Abbas1243/Decentralised_swarm_autonomous_ground_vehicle/software/simulation/frames_2026-03-26_16.52.51.pdf

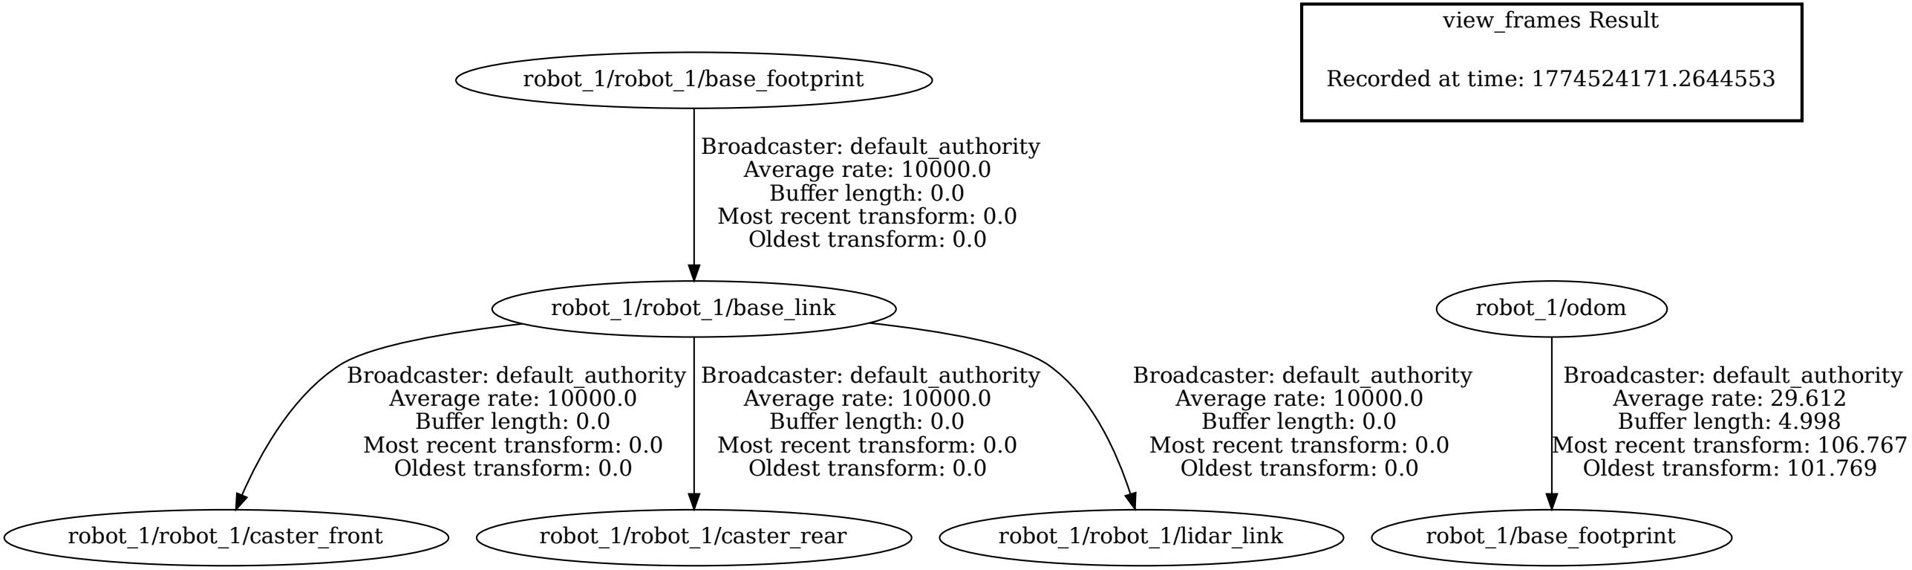
[picture p4: figure]
view_frames Result; robot_1/robot_1/base_footprint; robot_1/robot_1/base_link; Broadcaster: default_authority Average rate: 10000.0 Buffer length: 0.0 Most recent transform: 0.0 Oldest transform: 0.0; robot_1/robot_1/caster_front; robot_1/robot_1/caster_rear; robot_1/robot_1/lidar_link; robot_1/odom; robot_1/base_footprint; Broadcaster: default_authority Average rate: 29.612 Buffer length: 4.998 Most recent transform: 106.767 Oldest transform: 101.769; Recorded at time: 1774524171.2644553
