Abbas1243/Decentralised_swarm_autonomous_ground_vehicle/software/simulation/frames_2026-03-26_17.04.20.pdf

view_frames Result

Recorded at time: 1774524860.1898923

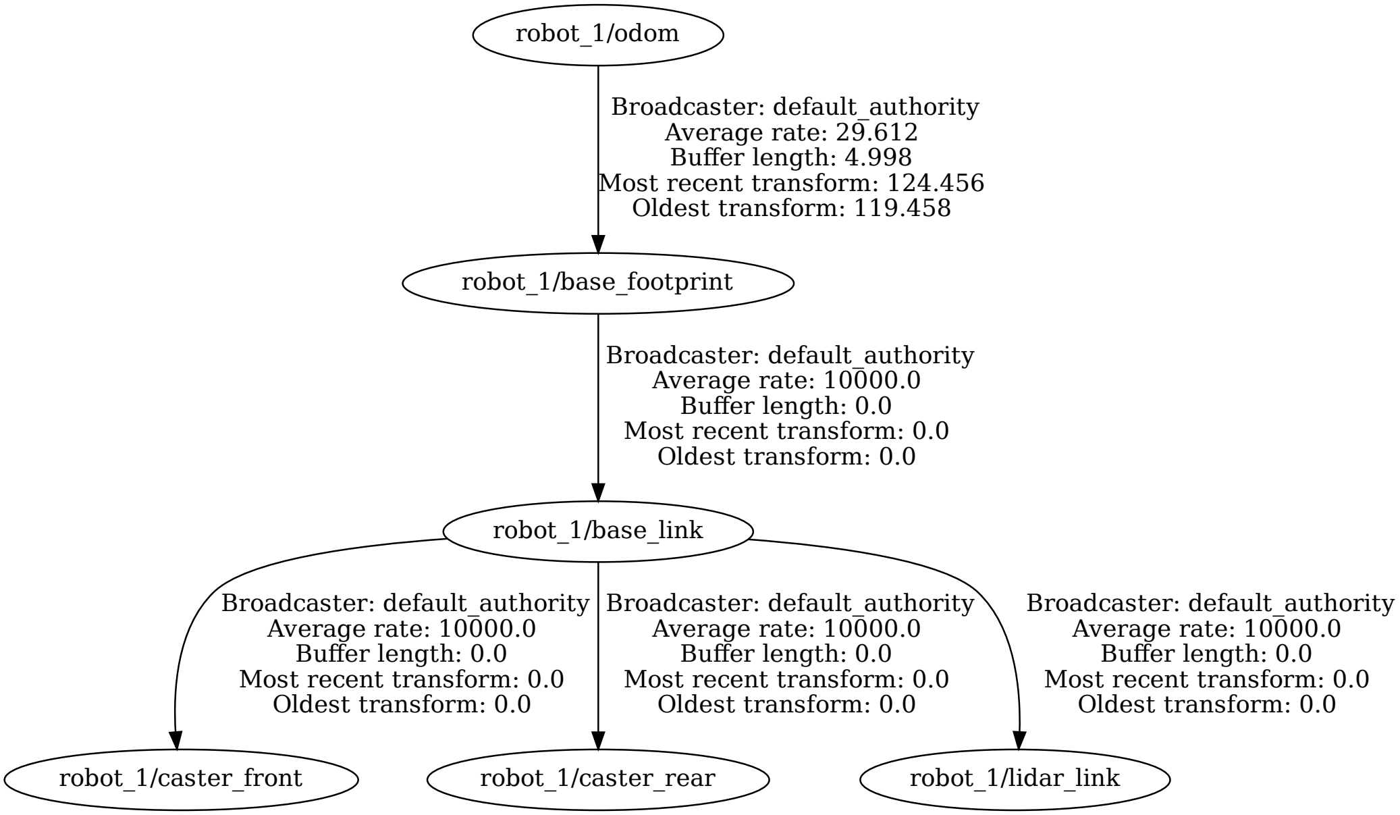
[picture p5: figure]
robot_1/odom; robot_1/base_footprint; Broadcaster: default_authority Average rate: 29.612 Buffer length: 4.998 Most recent transform: 124.456 Oldest transform: 119.458; robot_1/base_link; Broadcaster: default_authority Average rate: 10000.0 Buffer length: 0.0 Most recent transform: 0.0 Oldest transform: 0.0; robot_1/caster_front; robot_1/caster_rear; robot_1/lidar_link
