Abbas1243/Decentralised_swarm_autonomous_ground_vehicle/software/simulation/frames_2026-03-29_18.09.24.pdf

view_frames Result

Recorded at time: 1774787964.1346152

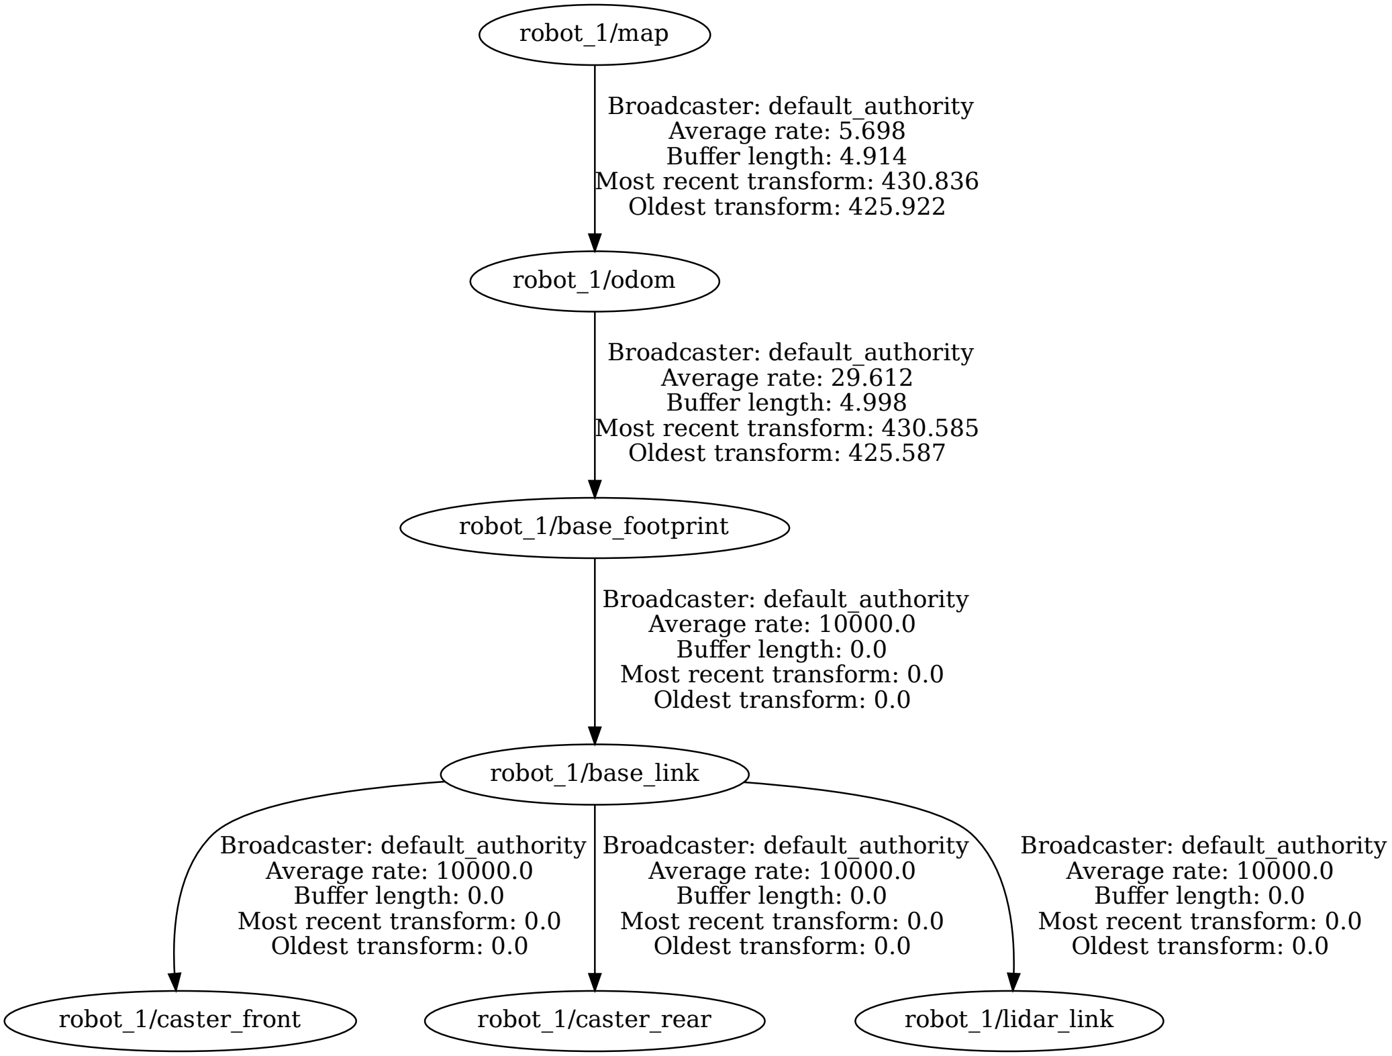
[picture p7: figure]
robot_1/base_footprint; robot_1/base_link; Broadcaster: default_authority Average rate: 10000.0 Buffer length: 0.0 Most recent transform: 0.0 Oldest transform: 0.0; robot_1/caster_front; robot_1/caster_rear; robot_1/lidar_link; robot_1/odom; Broadcaster: default_authority Average rate: 29.612 Buffer length: 4.998 Most recent transform: 430.585 Oldest transform: 425.587; robot_1/map; Broadcaster: default_authority Average rate: 5.698 Buffer length: 4.914 Most recent transform: 430.836 Oldest transform: 425.922
