Abbas1243/Decentralised_swarm_autonomous_ground_vehicle/software/simulation/rosgraph2.png

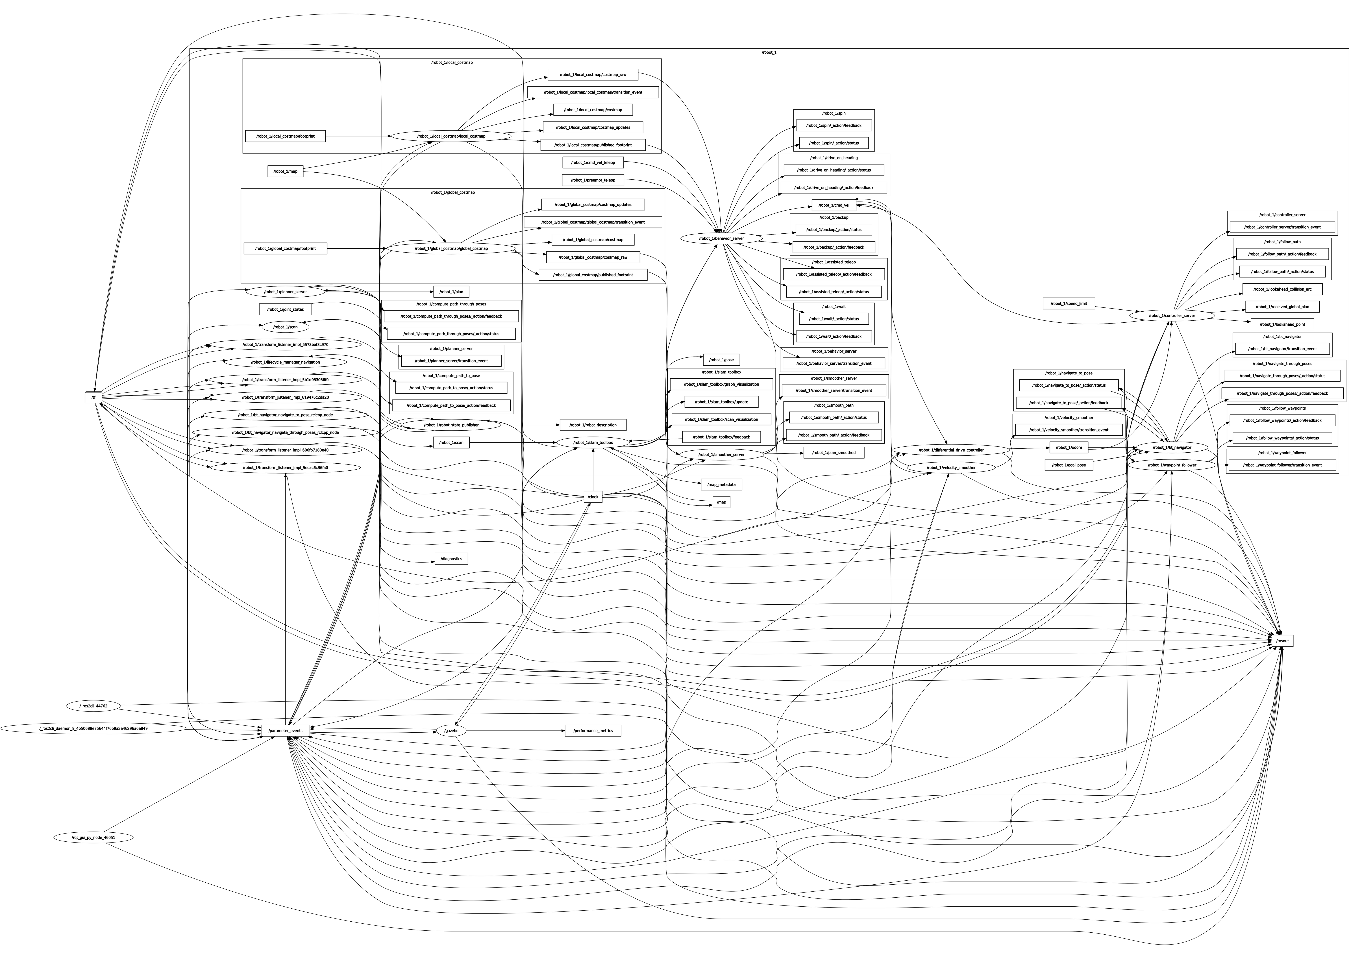
software/simulation/rosgraph2.png
