Abbas1243/Decentralised_swarm_autonomous_ground_vehicle/software/simulation/rosgraph.png

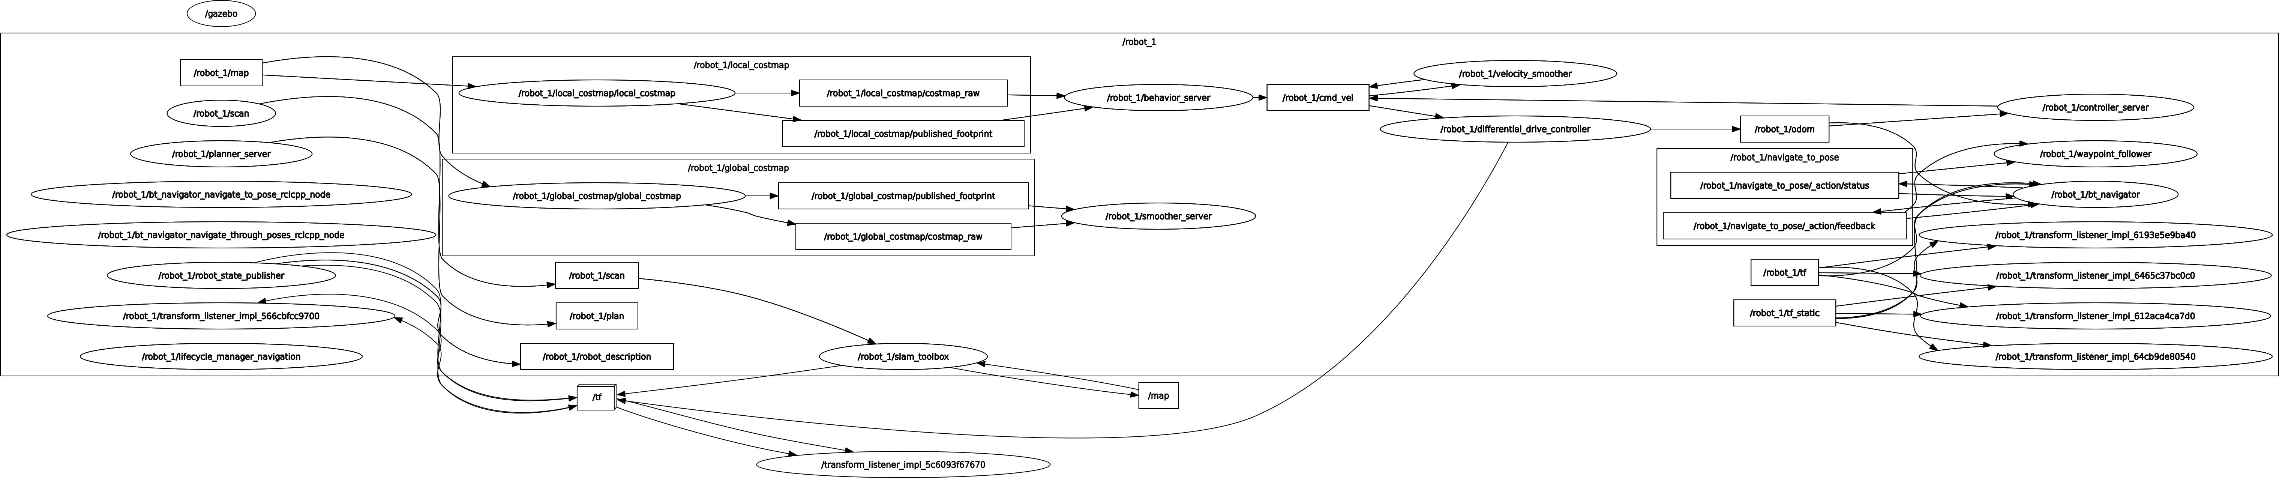
software/simulation/rosgraph.png
