Abbas1243/Decentralised_swarm_autonomous_ground_vehicle/software/Slam 2/files/bag_map_preview.png

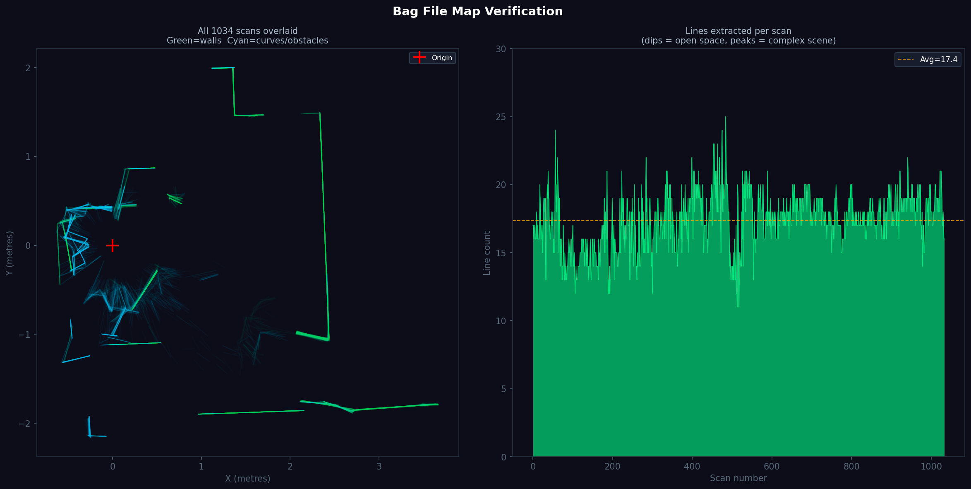
software/Slam 2/files/bag_map_preview.png
