Abbas1243/Decentralised_swarm_autonomous_ground_vehicle/hardware/pcb_design/ROB-14450.step

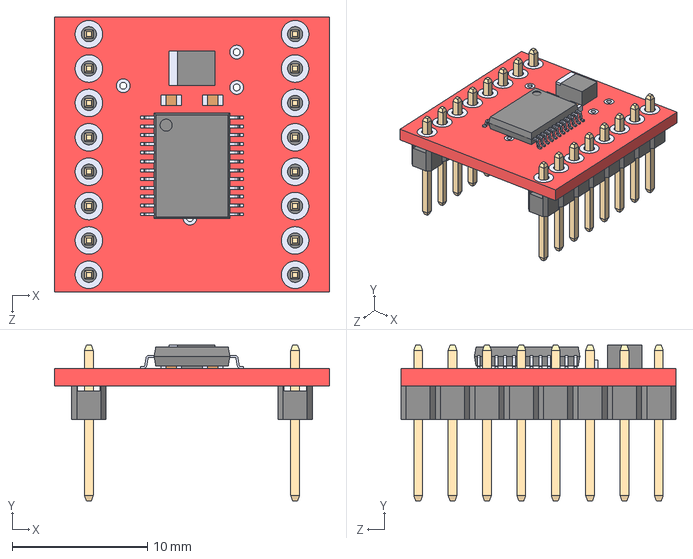
[picture p11: CAD file, 2026-08-23]
hardware/pcb_design/ROB-14450.step
20.3 x 11.5 x 20.3 mm
