Abbas1243/Decentralised_swarm_autonomous_ground_vehicle/hardware/pcb_design/ESP32-DEVKIT-V1.step

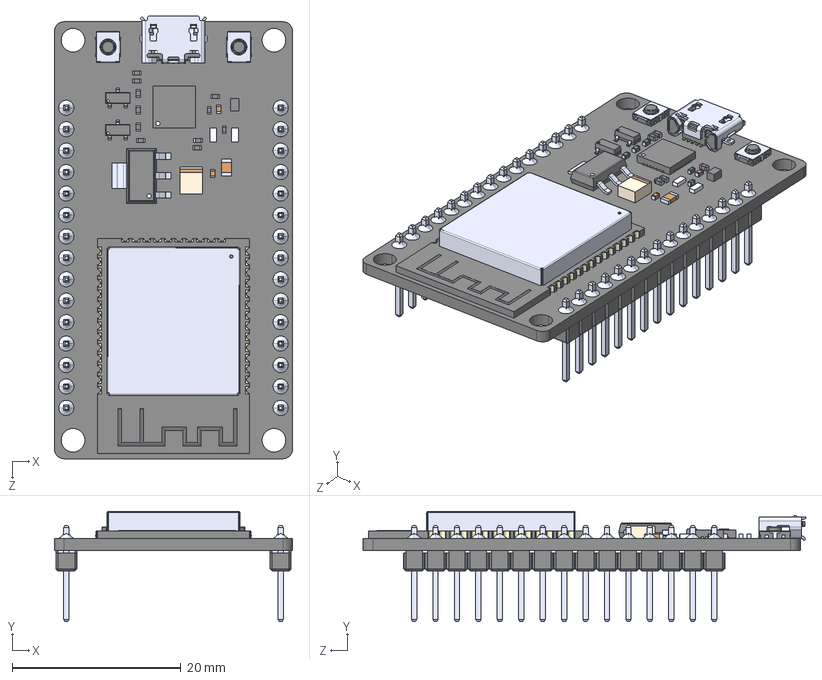
[picture p12: CAD file, 2026-08-23]
hardware/pcb_design/ESP32-DEVKIT-V1.step
28.2 x 13.1 x 52.5 mm
