Abbas1243/Decentralised_swarm_autonomous_ground_vehicle/(list of files, drawings)

Other design files:
hardware/pcb_design/Custom_board.dsn
