Abbas1243/Decentralised_swarm_autonomous_ground_vehicle/hardware/pcb_design/Custom_board.kicad_pcb

## KiCad design hardware/pcb_design/Custom_board.kicad_pcb (2026-08-23)

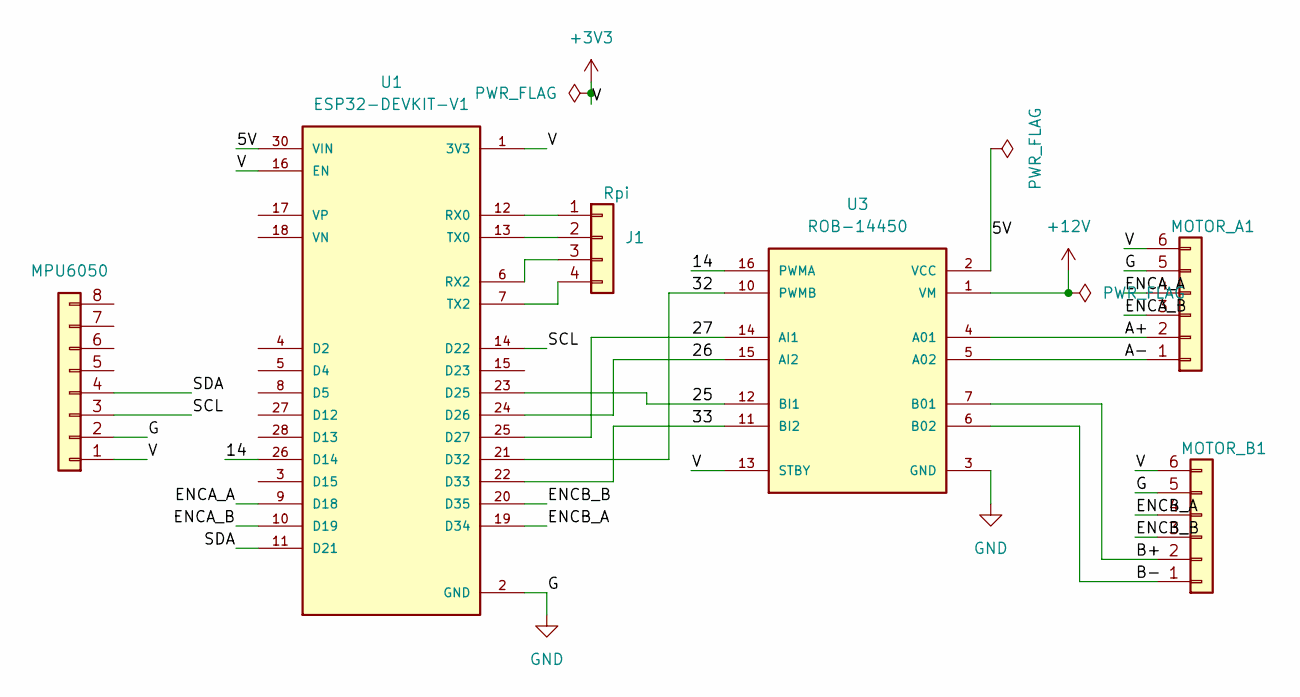
[picture p13: schematic Custom_board.kicad_sch]

Parts:
J1: Rpi; PinHeader_1x04_P2.54mm_Vertical
MOTOR_A1: Conn_01x06; PinHeader_1x06_P1.27mm_Vertical
MOTOR_B1: Conn_01x06; PinHeader_1x06_P1.27mm_Vertical
MPU6050: Conn_01x08; PinSocket_1x08_P2.54mm_Vertical
U1: ESP32-DEVKIT-V1; MODULE_ESP32_DEVKIT_V1; PARTREV N/A
U3: ROB-14450; MODULE_ROB-14450; PARTREV 11-13-17

Connections:
+3V3: MOTOR_A1.6, MOTOR_B1.6, MPU6050.1, U1.1 (3V3), U1.16 (EN), U3.13 (STBY)
+12V: U3.1 (VM)
/5V: U1.30 (VIN), U3.2 (VCC)
/14: U1.26 (D14), U3.16 (PWMA)
/25: U1.23 (D25), U3.12 (BI1)
/26: U1.24 (D26), U3.15 (AI2)
/27: U1.25 (D27), U3.14 (AI1)
/32: U1.21 (D32), U3.10 (PWMB)
/33: U1.22 (D33), U3.11 (BI2)
/A+: MOTOR_A1.2, U3.4 (A01)
/A-: MOTOR_A1.1, U3.5 (A02)
/B+: MOTOR_B1.2, U3.7 (B01)
/B-: MOTOR_B1.1, U3.6 (B02)
/ENCA_A: MOTOR_A1.4, U1.9 (D18)
/ENCA_B: MOTOR_A1.3, U1.10 (D19)
/ENCB_A: MOTOR_B1.4, U1.19 (D34)
/ENCB_B: MOTOR_B1.3, U1.20 (D35)
/SCL: MPU6050.3, U1.14 (D22)
/SDA: MPU6050.4, U1.11 (D21)
GND: MOTOR_A1.5, MOTOR_B1.5, MPU6050.2, U1.2 (GND), U1.29 (GND), U3.3 (GND), U3.8 (GND), U3.9 (GND)
unnamed: J1.1, U1.12 (RX0)
unnamed: J1.2, U1.13 (TX0)
unnamed: J1.3, U1.6 (RX2)
unnamed: J1.4, U1.7 (TX2)

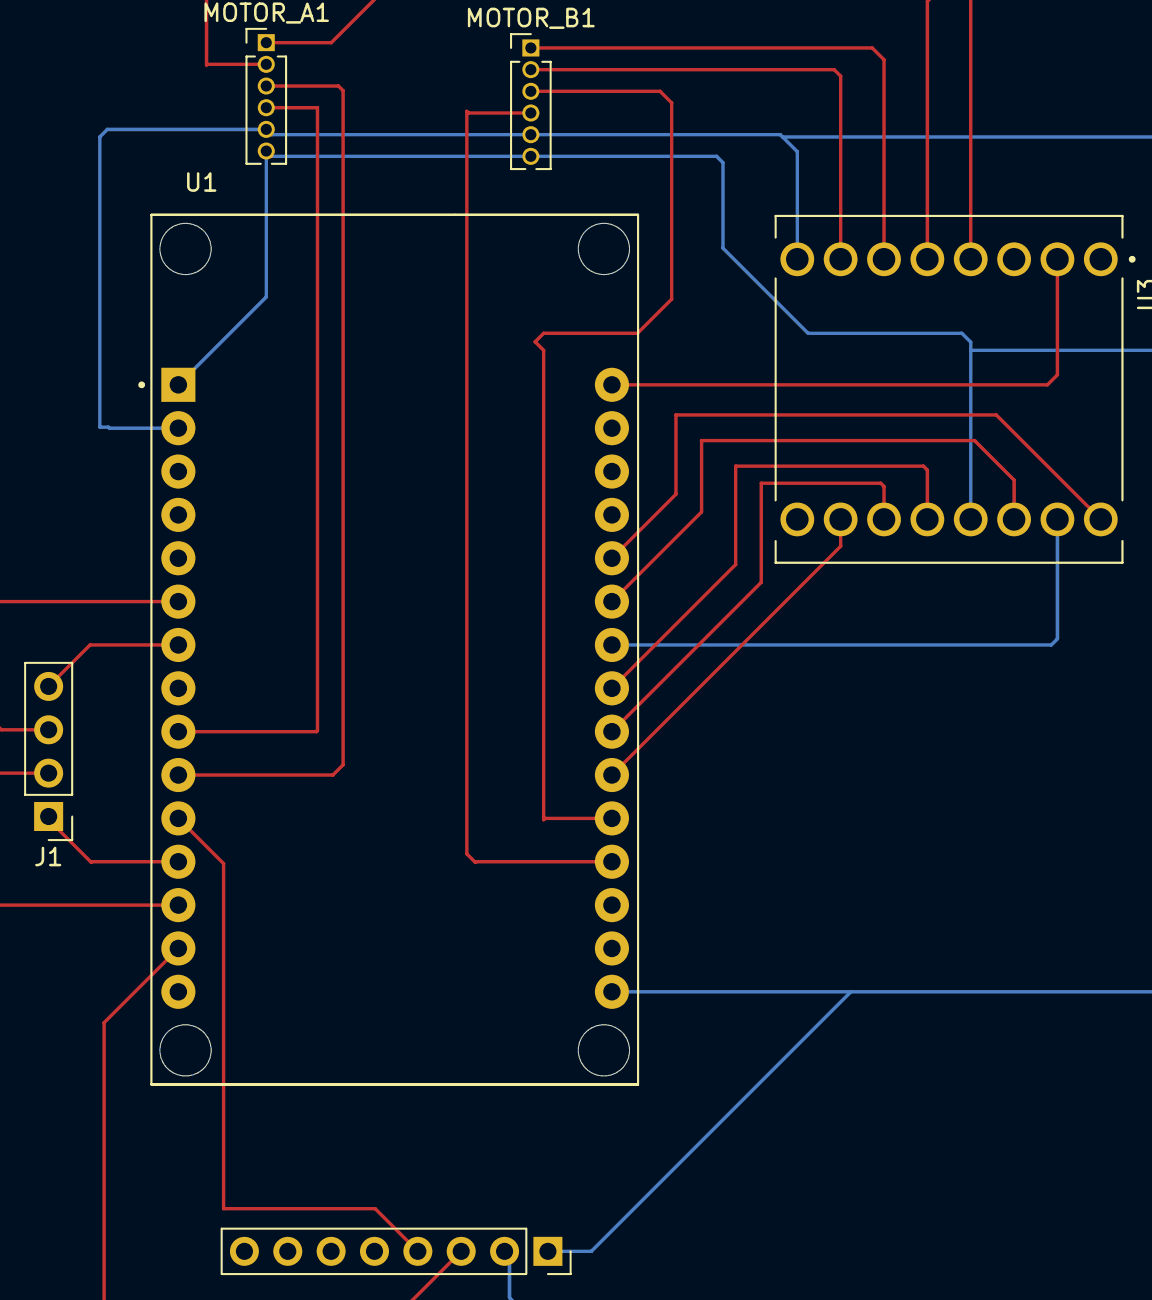
[picture p14: board Custom_board.kicad_pcb from above]

Board: 2 copper layers, 6 parts (0 on the bottom side), 23 nets.
