Abbas1243/Decentralised_swarm_autonomous_ground_vehicle/(commit log)

2026-08-23 Add files via upload
    PCB design
    [Custom_board.dsn, Custom_board.kicad_pcb, Custom_board.kicad_sch, ESP32-DEVKIT-V1.step, ROB-14450.step]
2026-08-23 software/Simulation: import Phase 0 + Phase 1 multi-robot sim (bringup, SLAM, Nav2, frontier exploration, map merger, fault detection, scan filter)
    === CONTEXT ===
    First import of the simulation codebase into this repo, under the agreed
    software/Simulation folder structure (this branch already has a software/
    folder from other subsystems). Covers everything built to date:
    Phase 0 (complete): single-robot Gazebo simulation, LiDAR, slam_toolbox,
    full Nav2 stack, autonomous navigation to RViz goal poses.
    Phase 1 (in progress): namespaced multi-robot simulation, unified bringup,
    peer-to-peer heartbeat fault detection, integration test, occupancy-grid
    map merger, merged-map-aware frontier expl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
    [swarm_bot.urdf.xacro]
2026-09-02 Initial commit: feature-based 2D SLAM — fit_first extractor through pose refinement
    Hardware: Milk-V Duo S + STM32F411 (fit_first feature extraction) + RPLIDAR A1
    Implemented and tested (Python reference, C port pending):
    - fit_first line/arc feature extraction (STM32-validated, 31fps on hardware)
    - line_matcher: hard 1:1 scan-to-map feature matching
    - map_manager: persistent feature map with STATIC/DYNAMIC/UNCLASSIFIED
    classification, decay, duplicate suppression
    - correlative_match: multi-resolution coarse pose search (pyramid search,
    ambiguity detection, guess-translation bug fixed)
    - soft_scan_matcher: soft-correspondence Gauss-Newton fine refinement
    (fixes hard-match correspond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
2026-11-10 both methodology and flowchart updated
